y-watal/Distributed-embedded-lab2/design_values_table.html

## Team Defined Values

### Drivetrain

Symbol | Proposed Value | Units | Rationale
THR_MIN | 300 | raw counts (0–32767) | Ignores very small throttle inputs near zero so pedal noise does not command the motors
BRK_MIN | 500 | raw counts (0–32767) | Brake input at or above this value fully applies the brake. Braking is on/off, not proportional
VALID_THR_RANGE | 0–32767 | raw counts | Valid throttle range. Anything outside it triggers a BAD_RANGE fault
VALID_BRK_RANGE | 0–32767 | raw counts | Valid brake range. Anything outside it triggers a BAD_RANGE fault
BRAKE_PRIORITY | Brake overrides throttle | — | If the brake is at or above BRK_MIN, the PID is reset and the H-bridge short-brakes, whatever the throttle is
V_MAX | 650 (≈2.76 rev/s) | mm/s | Target wheel speed at full throttle, set to the speed measured at about 70% duty
Throttle map | v = ((thr − THR_MIN) / (32767 − THR_MIN)) × V_MAX; v = 0 if thr ≤ THR_MIN | — | Monotonic map that starts from zero at the edge of the deadband, so there is no jump in speed
ENC_COUNTS_PER_REV | 1316 | encoder counts / wheel rev | Quadrature counts per wheel revolution. Converts encoder counts to wheel speed
WHEEL_CIRC | 235.6 | mm | Converts wheel revolutions to linear speed
CTRL_PERIOD | 20 | ms | Speed PID sample period
K_P / K_I / K_D | 1.0 / 2.0 / 0.0 | permille duty per mm/s (K_I per mm/s·s) | PI speed controller gains per wheel. Derivative is unused
FF_DUTY | 55% → 70% | duty | Linear feedforward duty from the smallest target speed (55%) up to V_MAX (70%). The PID corrects around it
I_LIMIT | ±40% | duty | Integral clamp with anti-windup
DUTY_MIN | 55% | duty | Lowest duty for a non-zero target (the feedforward floor). If throttle ≤ THR_MIN the motors coast at 0%
DUTY_MAX | 100% | duty | Full throttle sits near 70%, which leaves 30% for the PID to recover under load
PWM_FREQ | 10 | kHz | Frequency of the motor enable PWM
DUTY_STEP | +5% every 20 ms | duty cycle increase | Not implemented in lab 2. Load recovery came from the PI integral
I_OVERLOAD_THRESH | TBD | A | Current threshold above which the motor is considered overloaded
I_OPEN_THRESH | TBD | A | Current threshold below which a commanded motor is considered disconnected

### Steering and force feedback

Symbol | Proposed Value | Units | Rationale
STEER_RANGE | −32767 to +32766 | raw counts | Valid steering input range. Anything outside it triggers a BAD_RANGE fault
STEER_SAT | ±10000 | raw counts | Steering input that gives full servo travel. Inputs beyond it are clamped, not treated as errors
SERVO_MIN/MAX | 500 / 2500 | µs pulse | Servo command range, 0–180° at the servo
SERVO_CENTER | 1500 | µs pulse | Straight ahead. Commanded at startup and whenever the car isn't in NORMAL
SERVO_PERIOD | 20 (50 Hz) | ms | Servo PWM frame period
ANGLE_MAX | ±50 | degrees at the wheels | The servo is commanded ±90°. The wheel angle still has to be measured
Steering Map | pulse = 1500 + steer / 10, after clamping steer to ±STEER_SAT | µs | Linear map from ±10000 to 500–2500 µs
STEER_PERIOD | 20 | ms | Steering task update period. The servo is only written when the angle changes
I_FS | TBD | A | Steering actuator current at maximum force feedback. Set after hardware testing
Force Map | Linear from −I_FS to +I_FS into −100 to +100 | — | Converts measured steering load into the signed force value sent back to the steering wheel
FORCE_DB | 5 | force counts | Ignores very small force values near zero so measurement noise does not create steering wheel feedback

### Blinkers

Symbol | Proposed Value | Units | Rationale
BLINKER_ON | ±5000 | raw steering counts | Steering past this value counts as a deliberate turn and allows the blinker to cancel later
BLINKER_OFF | ±4000 | raw steering counts | The wheel must return inside this value before the active blinker cancels
LEFT_BLINKER_VALID | 0 = Off, 128 = Pressed | raw button value | Any other value triggers a BAD_RANGE fault
RIGHT_BLINKER_VALID | 0 = Off, 128 = Pressed | raw button value | Any other value triggers a BAD_RANGE fault
BLINKER_SELECT | Rising edge toggles | — | Pressing the active side again turns it off. Pressing the other side switches to it
TURN_BLINK_RATE | 1 | Hz | 500 ms on, 500 ms off
HAZARD_BLINK_RATE | 2 | Hz | 250 ms on, 250 ms off. Used in ERROR and SELF_TEST

### Safety

Symbol | Proposed Value | Units | Rationale
CMD_TIMEOUT | 90 | ms | No valid command for this long puts the car in ERROR (brake and hazards). Leaves margin for the 100 ms fault-response requirement
CMD_KEEPALIVE | 50 (minimum spacing 10) | ms | Unchanged state is resent at this rate, and changes are sent at most every 10 ms
FAULT_RECOVERY | Next valid command | — | An out-of-range value invalidates the stored command. Driving resumes only when a new valid command arrives
SAFETY_POLL | 5 | ms | Safety and blinker check rate. Link loss is detected within about 95 ms
BUTTON_DEBOUNCE | 30 | ms | Minimum time between accepted presses of the self-test button
SELF_TEST_EXIT | Double press within 350 | ms | A single press enters self-test (brake and hazards). A double press exits it
