y-watal/Distributed-embedded-lab2/CHANGELOG.md

# Changelog

Lab 5 (Raft consensus and time synchronization) changes on the `lab5` branch,
newest first. Each entry names its commit, what changed, why, and what the
bus showed afterwards. Wire formats and rules are in
[docs/lab5_protocol.md](docs/lab5_protocol.md); the plan is in
[roadmap.md](roadmap.md).

## 2026-11-12

### `4d2fa9f` Heartbeat may wait 0.5 ms for a TX buffer
- **Changed:** a node's own heartbeat waits up to `HB_TX_WAIT_US` (500 µs)
  for an MCP2515 TX buffer instead of `K_NO_WAIT`, only on a bus that is not
  degraded. CTRL, FAULT, BLINK, and relayed frames are unchanged.
  `queue_on()` in `canbus.c` takes the wait as a parameter.
- **Why:** the Zephyr MCP2515 driver frees a buffer slightly after its TX
  callback, so a `K_NO_WAIT` heartbeat could find none free while at most two
  frames were counted in flight. N2's heartbeat on bus B arrived 157/250
  times with a 180 ms gap.
- **Result:** every heartbeat on both buses (10 s capture: N2 500/500 on A and
  B, N3 500/500 and 499/499). N3 shows `full=0`; N2 shows `full` only on bus
  B, from relayed copies.

### `7a5b855` Raft sends are fail-safe; transmit debug counters
- **Changed:** a bulk Raft fragment waits up to 1 ms
  (`RAFT_TX_RESERVE_WAIT_US`) for a spare TX buffer, then is sent anyway with
  the old 2 ms wait, counted as `late`. It is never skipped. N2's relay does
  the same (`raftlate`). Each report bus line adds `tx q=` (frames
  `can_send()` accepted) and `infl N max M late L`.
- **Why:** the first version skipped a fragment after a 3 ms wait. Only
  fragment 0 of every message reached the bus (0 of 109 multi-frame messages
  complete), so N2 sat as a candidate at term 885 while N3 led at term 351.
- **Result:** 100/100 APPEND and APPEND_ACK messages complete; N2 and N3 agree
  on term and leader. `q` matches `ok` and `infl` is 0 when idle, so the
  in-flight count is accurate.

### `ead5b3e` MCP2515 SPI at 8 MHz request (5.25 MHz actual)
- **Changed:** `spi-max-frequency` from 4 MHz to 8 MHz in both STM32 overlays.
  SPI1 on the F401 runs from the 84 MHz APB2 clock with power-of-two dividers,
  so the real clock goes from 2.625 MHz to 5.25 MHz.
- **Why:** N2 relays about 190 frames/s through one SPI bus shared by both
  MCP2515s; its TX completions fell behind and its heartbeats were dropped.
- **Result:** N2's heartbeats on bus A went from 388/500 to 497/500 with no
  CAN errors at the new clock. Bus B still lost about 8% until `4d2fa9f`.

### `39b3912` Keep a TX buffer free for Lab 3 frames
- **STM32:** count frames in flight per bus from `can_send()` to the TX
  callback; bulk Raft fragments may use at most 2 of the 3 MCP2515 buffers
  (`RAFT_TX_MAX_INFLIGHT`). N2's relay applies the rule to relayed fragments
  and keeps forwarding CTRL and FAULT while one waits. N3's `relay.c` now
  matches N2's (it is compiled out on N3).
- **Pi:** Raft frames go out on a separate TX-only socket per bus with
  `SO_PRIORITY` 2 (pfifo_fast band 2); the Lab 3 socket uses 6 (band 0), so
  CTRL and HB are dequeued first. `can_rx` ignores N1's own Raft frames.
  `can_up.sh` raises `txqueuelen` from 10 to 32.
- **Why:** an empty APPEND is 4 fragments back to back; they filled all three
  MCP2515 buffers and the heartbeat, sent with `K_NO_WAIT`, was dropped
  (N3: 1-3 per second).
- **Note:** its skip-on-timeout rule broke Raft; fixed in `7a5b855`.

### `88ab415` Stop the CLIENT_REPLY storm; heartbeats outrank bulk Raft
- **CAN IDs:** REF stays at `0x040`-`0x042`. Votes, appends, and client
  messages move from `0x044`-`0x05A` to `0x140`-`0x156`, above the heartbeats
  (`0x100`-`0x102`). STM32 receive filters stay at six: BLINK and FORCE share
  one. `raft_id_slot()` keeps the transport's reassembly table compact.
- **Client pacing** (`shared/raft_agent.c`): link, node, and cockpit reports go
  through `raft_client_observe()` and are logged only after holding 50 ms
  (loss) or 100 ms (recovery). A newer state replaces a queued one for the
  same link or node. After `REJECTED` the client waits 1 s instead of 100 ms.
  The leader stays silent while another entry is in flight and answers its own
  client locally instead of over CAN.
- **Why:** the 64-entry log filled, the leader rejected every update, and
  clients resent every 100 ms (about 90 rejected replies/s per bus). That
  traffic outranked heartbeats, gaps reached 60-80 ms, DEG flickered, and each
  flicker added two more log reports. The term had reached 1389.
- **Tests:** host tests cover the ID order and filter masks, debounce,
  coalescing, the 1 s backoff, and the leader rejecting its own request
  without sending a frame.

### `2c9625f` Initial Raft
- Shared portable Raft core in `shared/` used by the Pi and both STM32s:
  `protocol.h` (CAN IDs), `raft_wire.h` (message codecs), `raft_transport.c`
  (5-byte fragments and reassembly), and `raft_agent.c` (roles, terms,
  elections, one-entry APPEND, commit on majority, network graph).
- Default startup: N1 leader in term 1, REF every 20 ms, empty APPEND every
  100 ms; followers elect after 3 missed REFs plus 0-39 ms of random delay.
  `RAFT_DEFAULT_LEADER -1` starts with an election instead.
- Lab 3 heartbeat monitors report CANLINK and NODE changes; the Pi reports
  COCKPIT_OK and COCKPIT_ERROR. Each node prints its term, log, and graph once
  a second.
- Host tests: `tests/raft_wire_test.c`, `raft_transport_test.c`,
  `raft_agent_test.c`.

## Known issues
- **Log capacity:** the working log holds 64 entries in RAM and is lost on
  reset. When full, the leader rejects every update. Needs a ring buffer with
  snapshots.
- **N2 relays everything:** about 70 relayed Raft frames/s are duplicates when
  all links are up, and relayed copies on bus B still fail with `full`.
  Relaying Raft frames only when the sender is not heard on the other bus
  would remove that load.
- **Elections:** no Pre-Vote or CheckQuorum, and a restarted cockpit claims
  term-1 leadership with an empty log, so the term can climb (checkoff step 10).
- **Not started:** clock synchronization (`global_gettime()`, drift), PPS,
  blinkers on global time, LEADER and SYNC indicators, failure-mode hazards,
  graph-based routing.
