y-watal/Distributed-embedded-lab2/schematic/KiCAD.kicad_sch

## KiCad design schematic/KiCAD.kicad_sch (2026-10-01, an earlier design)

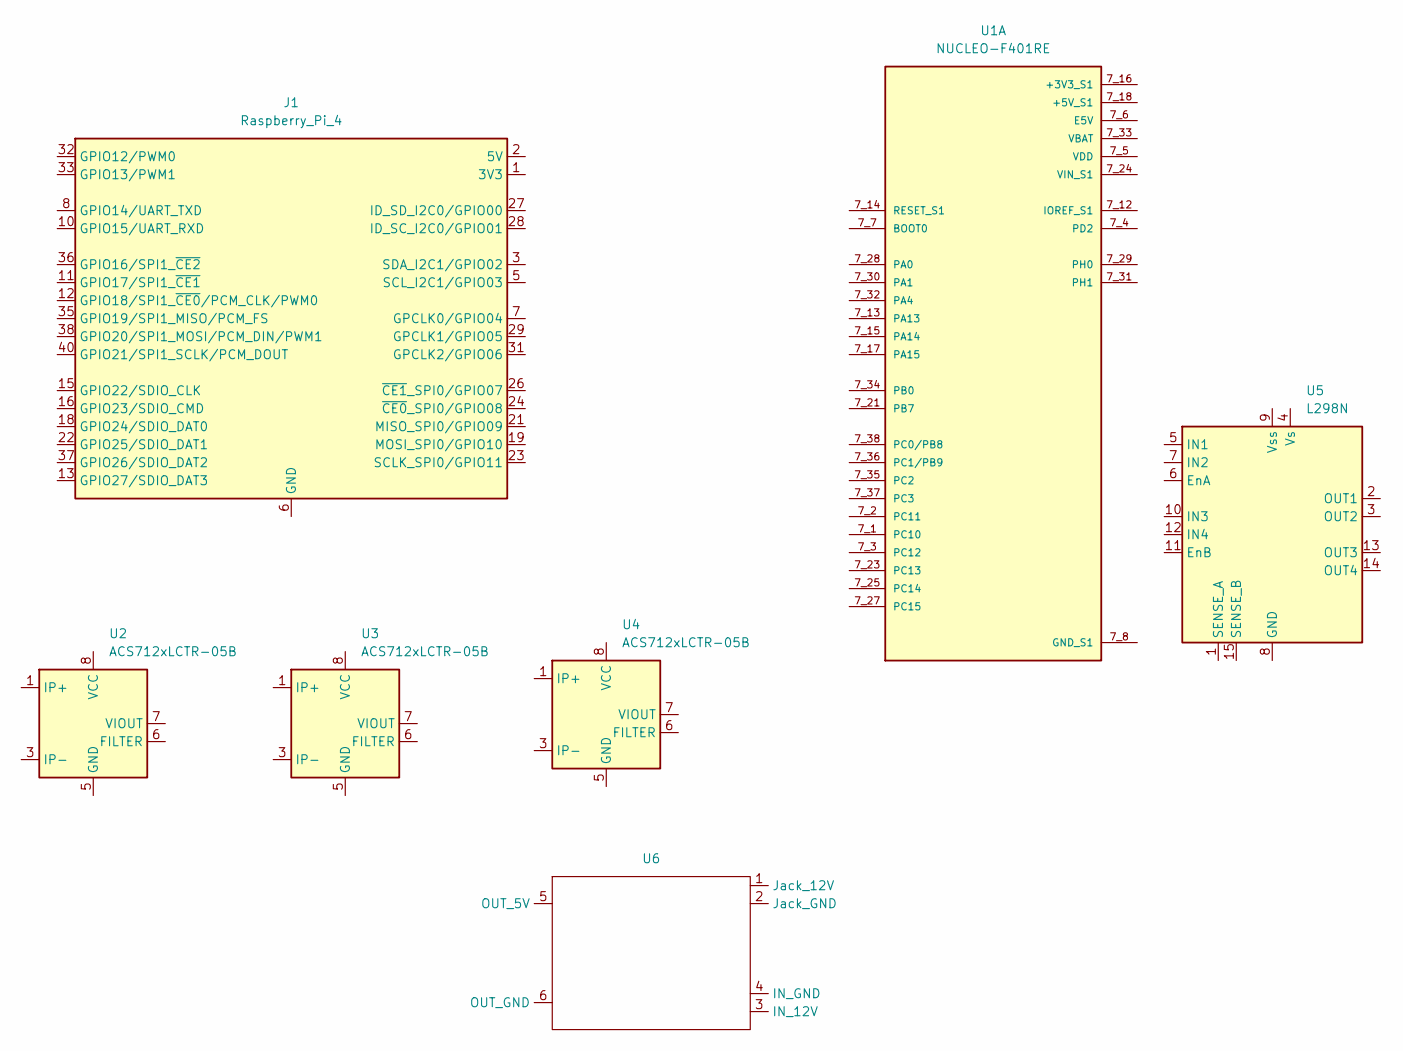
[picture p1: schematic KiCAD.kicad_sch]

Parts:
J1: Raspberry_Pi_4
U1: NUCLEO-F401RE; ST_NUCLEO-F401RE; PARTREV 13
U2, U3, U4: ACS712xLCTR-05B; SOIC-8_3.9x4.9mm_P1.27mm
U5: L298N; TO-220-15_P2.54x5.08mm_StaggerOdd_Lead4.58mm_Vertical
U6: WDFN-10-1EP_3x3mm_P0.5mm_EP1.8x2.5mm

Connections:
unnamed: J1.1 (3V3), J1.17 (3V3)
unnamed: J1.2 (5V), J1.4 (5V)
unnamed: J1.6 (GND), J1.9 (GND), J1.14 (GND), J1.20 (GND), J1.25 (GND), J1.30 (GND), J1.34 (GND), J1.39 (GND)
unnamed: U1.7_8 (GND_S1), U1.7_19 (GND_S1), U1.7_20 (GND_S1), U1.7_22 (GND_S1)
unnamed: U2.1 (IP+), U2.2 (IP+)
unnamed: U2.3 (IP-), U2.4 (IP-)
unnamed: U3.1 (IP+), U3.2 (IP+)
unnamed: U3.3 (IP-), U3.4 (IP-)
unnamed: U4.1 (IP+), U4.2 (IP+)
unnamed: U4.3 (IP-), U4.4 (IP-)
