y-watal/Distributed-embedded-lab2/schematic/Lab3.kicad_sch

## KiCad design schematic/Lab3.kicad_sch (2026-10-21)

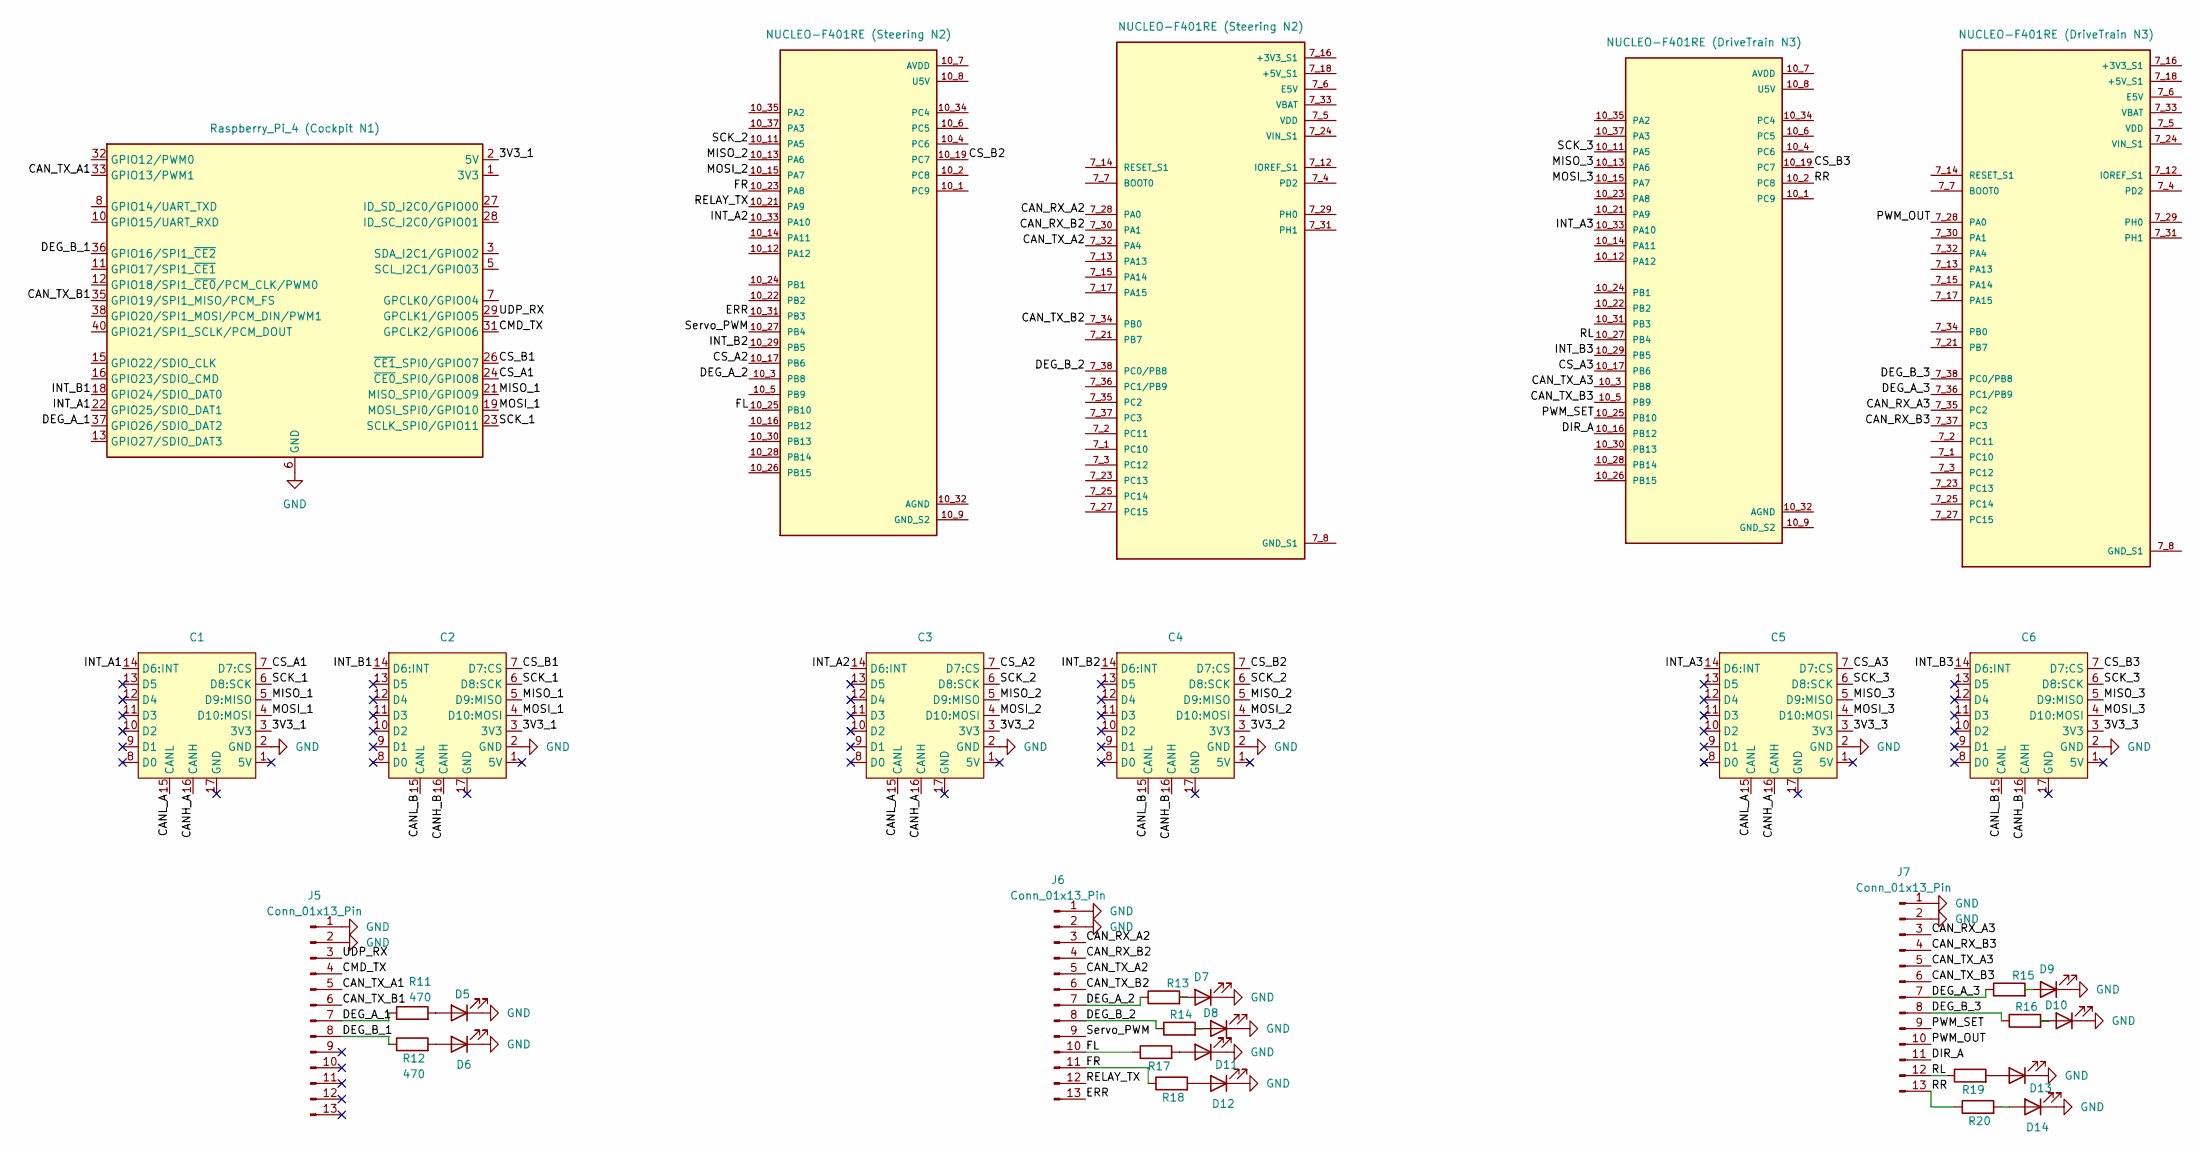
[picture p2: schematic Lab3.kicad_sch]

Parts:
C1, C2, C3, C4, C5, C6: (no value)
D5, D6, D7, D8, D9, D10, D11, D12, D13, D14: LED
J4: Raspberry_Pi_4 (Cockpit N1)
J5, J6, J7: Conn_01x13_Pin
R11, R13, R15, R17, R19: 470; DIP-8_W7.62mm
R12, R14, R16, R18, R20: 470
U6: NUCLEO-F401RE (DriveTrain N3); ST_NUCLEO-F401RE; PARTREV 13
U7: NUCLEO-F401RE (Steering N2); ST_NUCLEO-F401RE; PARTREV 13

Connections:
3V3_1: C1.3 (3V3), C2.3 (3V3), J4.2 (5V), J4.4 (5V)
3V3_2: C3.3 (3V3), C4.3 (3V3)
3V3_3: C5.3 (3V3), C6.3 (3V3)
CANH_A: C1.16 (CANH), C3.16 (CANH), C5.16 (CANH)
CANH_B: C2.16 (CANH), C4.16 (CANH), C6.16 (CANH)
CANL_A: C1.15 (CANL), C3.15 (CANL), C5.15 (CANL)
CANL_B: C2.15 (CANL), C4.15 (CANL), C6.15 (CANL)
CAN_RX_A2: J6.3, U7.7_28 (PA0)
CAN_RX_A3: J7.3, U6.7_35 (PC2)
CAN_RX_B2: J6.4, U7.7_30 (PA1)
CAN_RX_B3: J7.4, U6.7_37 (PC3)
CAN_TX_A1: J4.33 (GPIO13/PWM1), J5.5
CAN_TX_A2: J6.5, U7.7_32 (PA4)
CAN_TX_A3: J7.5, U6.10_3 (PB8)
CAN_TX_B1: J4.35 (GPIO19/SPI1_MISO/PCM_FS), J5.6
CAN_TX_B2: J6.6, U7.7_34 (PB0)
CAN_TX_B3: J7.6, U6.10_5 (PB9)
CMD_TX: J4.31 (GPCLK2/GPIO06), J5.4
CS_A1: C1.7 (D7:CS), J4.24 (~CE0_SPI0/GPIO08)
CS_A2: C3.7 (D7:CS), U7.10_17 (PB6)
CS_A3: C5.7 (D7:CS), U6.10_17 (PB6)
CS_B1: C2.7 (D7:CS), J4.26 (~CE1_SPI0/GPIO07)
CS_B2: C4.7 (D7:CS), U7.10_19 (PC7)
CS_B3: C6.7 (D7:CS), U6.10_19 (PC7)
DEG_A_1: J4.37 (GPIO26/SDIO_DAT2), J5.7, R11.1
DEG_A_2: J6.7, R13.1, U7.10_3 (PB8)
DEG_A_3: J7.7, R15.1, U6.7_36 (PC1/PB9)
DEG_B_1: J4.36 (GPIO16/SPI1_~CE2), J5.8, R12.1
DEG_B_2: J6.8, R14.1, U7.7_38 (PC0/PB8)
DEG_B_3: J7.8, R16.1, U6.7_38 (PC0/PB8)
DIR_A: J7.11, U6.10_16 (PB12)
ERR: J6.13, U7.10_31 (PB3)
FL: J6.10, R17.1, U7.10_25 (PB10)
FR: J6.11, R18.1, U7.10_23 (PA8)
GND: C1.2 (GND), C2.2 (GND), C3.2 (GND), C4.2 (GND), C5.2 (GND), C6.2 (GND), D5.1 (K), D6.1 (K), D7.1 (K), D8.1 (K), D9.1 (K), D10.1 (K), D11.1 (K), D12.1 (K), D13.1 (K), D14.1 (K), J4.6 (GND), J4.9 (GND), J4.14 (GND), J4.20 (GND), J4.25 (GND), J4.30 (GND), J4.34 (GND), J4.39 (GND), J5.1, J5.2, J6.1, J6.2, J7.1, J7.2
INT_A1: C1.14 (D6:INT), J4.22 (GPIO25/SDIO_DAT1)
INT_A2: C3.14 (D6:INT), U7.10_33 (PA10)
INT_A3: C5.14 (D6:INT), U6.10_33 (PA10)
INT_B1: C2.14 (D6:INT), J4.18 (GPIO24/SDIO_DAT0)
INT_B2: C4.14 (D6:INT), U7.10_29 (PB5)
INT_B3: C6.14 (D6:INT), U6.10_29 (PB5)
MISO_1: C1.5 (D9:MISO), C2.5 (D9:MISO), J4.21 (MISO_SPI0/GPIO09)
MISO_2: C3.5 (D9:MISO), C4.5 (D9:MISO), U7.10_13 (PA6)
MISO_3: C5.5 (D9:MISO), C6.5 (D9:MISO), U6.10_13 (PA6)
MOSI_1: C1.4 (D10:MOSI), C2.4 (D10:MOSI), J4.19 (MOSI_SPI0/GPIO10)
MOSI_2: C3.4 (D10:MOSI), C4.4 (D10:MOSI), U7.10_15 (PA7)
MOSI_3: C5.4 (D10:MOSI), C6.4 (D10:MOSI), U6.10_15 (PA7)
unnamed: D5.2 (A), R11.2
unnamed: D6.2 (A), R12.2
unnamed: D7.2 (A), R13.2
unnamed: D8.2 (A), R14.2
unnamed: D9.2 (A), R15.2
unnamed: D10.2 (A), R16.2
unnamed: D11.2 (A), R17.2
unnamed: D12.2 (A), R18.2
unnamed: D13.2 (A), R19.2
unnamed: D14.2 (A), R20.2
unnamed: J4.1 (3V3), J4.17 (3V3)
unnamed: U6.7_8 (GND_S1), U6.7_19 (GND_S1), U6.7_20 (GND_S1), U6.7_22 (GND_S1)
unnamed: U6.10_9 (GND_S2), U6.10_20 (GND_S2)
unnamed: U7.7_8 (GND_S1), U7.7_19 (GND_S1), U7.7_20 (GND_S1), U7.7_22 (GND_S1)
unnamed: U7.10_9 (GND_S2), U7.10_20 (GND_S2)
PWM_OUT: J7.10, U6.7_28 (PA0)
PWM_SET: J7.9, U6.10_25 (PB10)
RELAY_TX: J6.12, U7.10_21 (PA9)
RL: J7.12, R19.1, U6.10_27 (PB4)
RR: J7.13, R20.1, U6.10_2 (PC8)
SCK_1: C1.6 (D8:SCK), C2.6 (D8:SCK), J4.23 (SCLK_SPI0/GPIO11)
SCK_2: C3.6 (D8:SCK), C4.6 (D8:SCK), U7.10_11 (PA5)
SCK_3: C5.6 (D8:SCK), C6.6 (D8:SCK), U6.10_11 (PA5)
Servo_PWM: J6.9, U7.10_27 (PB4)
UDP_RX: J4.29 (GPCLK1/GPIO05), J5.3
