y-watal/Distributed-embedded-lab2/node2_front/src/lab3_config.h

/*
 * Every timing threshold and thread priority in one place (handout Part 5).
 * Derivations: docs/lab3_design.md.
 */
#ifndef LAB3_CONFIG_H
#define LAB3_CONFIG_H

/* Heartbeats (R4.5): every 20 ms +-10 %. */
#define HB_PERIOD_MS       20
#define HB_MAX_INTERVAL_MS 22

/*
 * A bus is degraded at this node when no other node's heartbeat has arrived on
 * it for DEG_TIMEOUT_MS. Worst-case detection is DEG_TIMEOUT_MS + MONITOR_PERIOD_MS
 * = 49 ms, inside R4.7's 60 ms. Two intervals keeps it clear of the longest
 * healthy gap (~24 ms), so the LED doesn't flicker.
 */
#define DEG_TIMEOUT_MS (2 * HB_MAX_INTERVAL_MS)

/*
 * A zone has failed when its heartbeat has been missing on both buses for
 * FAIL_TIMEOUT_MS: three missed heartbeats, each allowed its 22 ms window.
 * Worst case 66 + 5 = 71 ms, leaving 29 ms of the 100 ms system-error budget.
 */
#define FAIL_TIMEOUT_MS (3 * HB_MAX_INTERVAL_MS)

#define MONITOR_PERIOD_MS 5

/*
 * Copies of one (ID, seq) - bus A, bus B, relayed - all arrive within a few ms.
 * A repeat of the same seq inside this window is a duplicate; outside it, the
 * 4-bit counter has wrapped and it's a new frame. Must stay below the shortest
 * interval between two frames of one ID (18 ms).
 */
#define DUP_WINDOW_MS 10

#define REPORT_PERIOD_MS 1000

/*
 * CTRL older than this is stale: actuators go to their safe state (brake /
 * center). Lab 2's 90 ms: four missed 20 ms CTRL frames, plus margin.
 */
#define CTRL_TIMEOUT_MS 90

/* Actuator tasks re-check CTRL freshness and zone state at least this often. */
#define ACTUATOR_POLL_MS 5

#define PID_PERIOD_MS     10 /* N3 speed loop (template: PID every 10 ms) */
#define CURRENT_PERIOD_MS 20 /* current sensor sampling */

/* Zone state machine (docs/lab3_design.md, "Zone state and fault protocol") */
#define TEST_BTN_DEBOUNCE_MS 50   /* template: TEST_BTN min interarrival 50 ms */
#define DOUBLE_PRESS_MS      350  /* second press within this clears the test fault */
#define CTRL_FAULT_HOLD_MS   1000 /* a rejected CTRL keeps the zone in error this long */
#define FAULT_CLEAR_HOLD_MS  (HB_MAX_INTERVAL_MS + 3) /* older HB may overtake a FAULT */
#define FAULT_MIN_GAP_MS     20   /* catalog: FAULT min interval */

/* Blinkers */
#define BLINK_HALF_MS  500  /* local hazard rate when the cockpit can't be heard (1 Hz) */
/*
 * No BLINK for this long while N1's heartbeat is still heard: flash hazards
 * locally. Losing the cockpit is detected by the heartbeat (66 ms); this is
 * only a backstop for a cockpit that is alive but has stopped sending BLINK,
 * so it tolerates 5 lost toggles. At 1100 ms (2 lost), a couple of frames
 * dropped on a single-path relay (one bus unplugged) put up false hazards.
 */
#define BLINK_STALE_MS (5 * BLINK_HALF_MS + 100)

/* FORCE_TX (N2): dummy counter every 50 ms */
#define FORCE_PERIOD_MS 50

/* Independent watchdog (R4.5): fed only while HB_TX and the actuator task check in. */
#define WDT_TIMEOUT_MS 250
#define WDT_CHECK_MS   100

/* Boot-time test point walk, ms per point; 0 skips it. */
#define TP_WALK_MS 300

/*
 * Thread priorities (lower number = higher priority). The MCP2515 driver's two
 * interrupt threads run at CONFIG_CAN_MCP2515_INT_THREAD_PRIO (2), above all of these.
 * RELAY sits above DISPATCH so a forwarded CTRL goes out before N2's own tasks
 * see the frame: it is on N3's brake path.
 */
/*
 * Lab 5: bulk Raft fragments prefer to occupy at most 2 of the MCP2515's 3
 * TX buffers, so a K_NO_WAIT heartbeat, CTRL, or FAULT finds one free. A
 * fragment waits up to RAFT_TX_RESERVE_WAIT_US for that, then is sent anyway
 * (with the old 2 ms wait for any buffer) and counted as "late". Skipping
 * fragments instead lost every multi-frame message (N2/N3 split, term 885).
 */
/*
 * Own heartbeat waits up to this long for an MCP2515 TX buffer instead of
 * K_NO_WAIT (the driver frees a buffer slightly after the TX callback).
 * Adds at most this much heartbeat jitter, far inside HB_MAX_INTERVAL_MS.
 */
#define HB_TX_WAIT_US           500

#define RAFT_TX_MAX_INFLIGHT    2
#define RAFT_TX_RESERVE_WAIT_US 1000

#define PRIO_RELAY    3
#define PRIO_DISPATCH 4
#define PRIO_DRIVE    5 /* N3: acts on CTRL (brake path, local deadline 0.5 ms) */
#define PRIO_STEER    5 /* N2: acts on CTRL (local deadline 1 ms) */
#define PRIO_BLINK    5 /* BLINK_F / BLINK_R: 0.5 ms from reception */
#define PRIO_TEST_BTN 5 /* local fail within 10 ms (R2.5) */
#define PRIO_PID      6 /* N3: speed loop every 10 ms */
#define PRIO_HB_TX    7
#define PRIO_HB_MON   8 /* also runs the zone state machine and feeds the watchdog */
#define PRIO_FORCE    9 /* N2: FORCE every 50 ms */
#define PRIO_CURRENT  10
#define PRIO_REPORT   12
#define PRIO_EVLOG    13 /* event lines; below REPORT so it never splits a summary */

/*
 * WCET measurement (src/wcet.c): CPU time per job from Zephyr's per-thread
 * usage counter, which stops while the thread is preempted or blocked.
 * Needs CONFIG_THREAD_RUNTIME_STATS / CONFIG_SCHED_THREAD_USAGE in prj.conf.
 * 0 compiles every probe away.
 */
#define WCET_MEASURE      1
#define WCET_REPORT_EVERY 5 /* print the WCET table with every 5th summary */

/*
 * Queuing jitter J per message (src/jitter.c): trigger -> frame queued in the
 * MCP2515, wall clock, per bus. 0 compiles the recording away.
 */
#define JITTER_MEASURE      1
#define JITTER_REPORT_EVERY 5 /* print with every 5th summary; "last" = that window */

#endif /* LAB3_CONFIG_H */
