y-watal/Distributed-embedded-lab2/pi/state.h

typedef struct DIJOYSTATE2 {
    int lX;
    int lY;
    int lZ;
    int lRx;
    int lRy;
    int lRz;
    int rglSlider[2];
    unsigned rgdwPOV[4];
    char rgbButtons[128];
    int lVX;
    int lVY;
    int lVZ;
    int lVRx;
    int lVRy;
    int lVRz;
    int rglVSlider[2];
    int lAX;
    int lAY;
    int lAZ;
    int lARx;
    int lARy;
    int lARz;
    int rglASlider[2];
    int lFX;
    int lFY;
    int lFZ;
    int lFRx;
    int lFRy;
    int lFRz;
    int rglFSlider[2];
} DIJOYSTATE2_t;
