y-watal/Distributed-embedded-lab2/node2_front/src/canbus.h

/*
 * Shared dual-CAN layer.
 *
 *  - Both MCP2515 controllers, with receive filters for the catalog IDs only.
 *  - canbus_send(): queues one frame on bus A and bus B back to back with the
 *    same per-ID sequence number, bumped once.
 *  - One dispatch thread that drops duplicates by (ID, seq) - the A copy, the
 *    B copy and any relayed copy - before anything else sees the frame, and
 *    records when each node's heartbeat was last heard on each bus.
 */
#ifndef CANBUS_H
#define CANBUS_H

#include <stdbool.h>
#include <stdint.h>
#include <zephyr/drivers/can.h>
#include <zephyr/sys/atomic.h>

#include "catalog.h"

enum { BUS_A = 0, BUS_B = 1, NUM_BUSES = 2 };

/* Called from the dispatch thread with the first copy of each frame. */
typedef void (*canbus_handler_t)(const struct can_frame *frame, int bus);

int canbus_init(void);

/* Receivers of first copies. The relay hook runs before the application handler. */
void canbus_set_relay_hook(canbus_handler_t hook);
void canbus_set_handler(canbus_handler_t handler);

/*
 * Sends payload (bytes 1-7 used; byte 0 is overwritten with the sequence
 * number) on both buses. Buses marked degraded are skipped unless
 * include_degraded is set (heartbeats keep going out so the link can recover).
 */
int canbus_send(uint32_t id, uint8_t payload[FRAME_DLC], bool include_degraded);

/*
 * Same, recording J = now - release (k_cycle_get_32() of the triggering event,
 * from jit_now()) per bus once each copy is queued. release 0 records nothing.
 */
int canbus_send_at(uint32_t id, uint8_t payload[FRAME_DLC], bool include_degraded,
		   uint32_t release);

/* Sends one raw Lab 5 frame without overwriting byte 0 with a Lab 3 sequence. */
/*
 * True while bulk Raft frames may use another TX buffer on this bus: at most
 * RAFT_TX_MAX_INFLIGHT of the MCP2515's three, so Lab 3 frames keep one.
 */
bool canbus_raft_tx_ready(int bus);

/*
 * Wait up to RAFT_TX_RESERVE_WAIT_US for canbus_raft_tx_ready(). Returns
 * false on timeout; the caller then sends anyway (fail-safe: a Raft message
 * is never abandoned part-way because of the reserve).
 */
bool canbus_raft_wait_reserve(int bus);

/* Frames handed to the MCP2515 and not yet completed (debug). */
long canbus_tx_inflight(int bus);
int canbus_send_raft(uint32_t id, const uint8_t payload[FRAME_DLC]);

/* Queues a bit-identical copy of frame on one bus (the relay). */
int canbus_forward(int bus, const struct can_frame *frame);
int canbus_forward_at(int bus, const struct can_frame *frame, uint32_t release);

/* In a relay hook / handler: k_cycle_get_32() when rx_cb got this frame. */
uint32_t canbus_rx_cycles(void);

/* Aborts every transmission still pending on bus (stale frames on a dead link). */
void canbus_flush(int bus);

bool canbus_bus_running(int bus);
void canbus_set_degraded(int bus, bool degraded);
bool canbus_is_degraded(int bus);

/*
 * k_uptime_get_32() of the last heartbeat from node on bus (any copy, relayed
 * or not); 0 = never heard.
 */
uint32_t canbus_last_hb_ms(int bus, int node);

/* True once if the controller went bus-off since the last call. */
bool canbus_take_busoff(int bus);

/* ---- statistics, read and cleared by the report thread ---- */
#define CANBUS_NUM_SLOTS 9 /* catalog IDs */

struct canbus_bus_stats {
	atomic_t rx[CANBUS_NUM_SLOTS]; /* every copy received on this bus */
	atomic_t tx_ok, tx_err, tx_full, tx_skipped;
	atomic_t tx_queued; /* can_send() accepted; should equal tx_ok + tx_err */
	atomic_t raft_late; /* Raft sent without the reserve: none free within the wait */
	atomic_t infl_max;  /* most frames in flight seen at a send */
};

struct canbus_stats {
	struct canbus_bus_stats bus[NUM_BUSES];
	atomic_t accepted[CANBUS_NUM_SLOTS]; /* first copies */
	atomic_t gaps[CANBUS_NUM_SLOTS];     /* sequence numbers never received */
	atomic_t duplicates, own_echo, unknown_id, rx_dropped;
};

extern struct canbus_stats canbus_stats;
extern const uint16_t canbus_slot_id[CANBUS_NUM_SLOTS];
const struct device *canbus_dev(int bus);

#endif /* CANBUS_H */
