y-watal/Distributed-embedded-lab2/node3_rear/src/report.c

#include "report.h"

#include <zephyr/kernel.h>
#include <zephyr/sys/printk.h>

#include "app.h"
#include "blink.h"
#include "zone.h"
#include "canbus.h"
#include "ctrl.h"
#include "hb.h"
#include "lab3_config.h"
#include "node_config.h"
#include "relay.h"
#include "raft_node.h"
#include "jitter.h"
#include "wcet.h"

#define REPORT_STACK_SIZE 1536

K_THREAD_STACK_DEFINE(report_stack, REPORT_STACK_SIZE);
static struct k_thread report_data;

static const char *can_state_name(enum can_state state)
{
	switch (state) {
	case CAN_STATE_ERROR_ACTIVE:
		return "error-active";
	case CAN_STATE_ERROR_WARNING:
		return "error-warning";
	case CAN_STATE_ERROR_PASSIVE:
		return "error-passive";
	case CAN_STATE_BUS_OFF:
		return "bus-off";
	case CAN_STATE_STOPPED:
		return "stopped";
	default:
		return "?";
	}
}

static void print_counts(atomic_t *counts, atomic_t *gaps)
{
	bool any = false;

	for (int i = 0; i < CANBUS_NUM_SLOTS; i++) {
		long n = (long)atomic_clear(&counts[i]);
		long g = gaps ? (long)atomic_clear(&gaps[i]) : 0;

		if (n == 0 && g == 0) {
			continue;
		}
		printk(" 0x%03x x%ld", canbus_slot_id[i], n);
		if (g) {
			printk(" (gaps %ld)", g);
		}
		any = true;
	}
	if (!any) {
		printk(" (nothing)");
	}
}

static void report_thread(void *p1, void *p2, void *p3)
{
	int64_t next = k_uptime_get() + REPORT_PERIOD_MS;
	struct wcet_job job = WCET_JOB(WCET_REPORT);
	unsigned int reports = 0;

	ARG_UNUSED(p1);
	ARG_UNUSED(p2);
	ARG_UNUSED(p3);

	for (;;) {
		wcet_end(&job);
		k_sleep(K_TIMEOUT_ABS_MS(next));
		wcet_begin(&job);
		next += REPORT_PERIOD_MS;

		uint32_t ms = k_uptime_get_32();
		struct canbus_stats *s = &canbus_stats;

		uint8_t lf = zone_local_fault();

		printk("[%s %u.%03us] %s", NODE_NAME, ms / 1000, ms % 1000,
		       zone_state_name(zone_state()));
		if (lf) {
			printk(" (local fault 0x%02x)", lf);
		}
		printk(" | peers:");
		for (int n = 0; n < NUM_NODES; n++) {
			uint8_t code;

			if (n == NODE_SELF) {
				continue;
			}
			if (!hb_peer_alive(n)) {
				printk(" N%d LOST", n + 1);
			} else if (zone_peer_fault(n, &code)) {
				printk(" N%d fault 0x%02x", n + 1, code);
			} else {
				printk(" N%d %s", n + 1, zone_state_name(zone_peer_state(n)));
			}
		}
		printk(" | dup %ld echo %ld rxdrop %ld", (long)atomic_clear(&s->duplicates),
		       (long)atomic_clear(&s->own_echo), (long)atomic_clear(&s->rx_dropped));
		if (RELAY_ENABLED) {
			printk(" | relay %ld skip %ld drop %ld raftlate %ld",
			       (long)atomic_clear(&relay_stats.forwarded),
			       (long)atomic_clear(&relay_stats.skipped),
			       (long)atomic_clear(&relay_stats.dropped),
			       (long)atomic_clear(&relay_stats.raft_late));
		}
		printk("\n");

		for (int bus = 0; bus < NUM_BUSES; bus++) {
			struct canbus_bus_stats *b = &s->bus[bus];

			if (!canbus_bus_running(bus)) {
				printk("  %c: not running\n", 'A' + bus);
				continue;
			}
			enum can_state st;
			struct can_bus_err_cnt err = {0};

			can_get_state(canbus_dev(bus), &st, &err);
			/* MCP2515 RX overruns: a frame arrived with both RX buffers still unread. */
			static uint32_t ovr_prev[NUM_BUSES];
			uint32_t ovr = 0;
#ifdef CONFIG_CAN_STATS
			uint32_t ovr_now = can_stats_get_rx_overruns(canbus_dev(bus));

			ovr = ovr_now - ovr_prev[bus];
			ovr_prev[bus] = ovr_now;
#endif
			printk("  %c: %s tec=%u rec=%u ovr=%u DEG %d | tx q=%ld ok=%ld err=%ld full=%ld skip=%ld"
			       " | infl %ld max %ld late %ld | rx:",
			       'A' + bus, can_state_name(st), err.tx_err_cnt, err.rx_err_cnt, ovr,
			       hb_bus_degraded(bus), (long)atomic_clear(&b->tx_queued),
			       (long)atomic_clear(&b->tx_ok),
			       (long)atomic_clear(&b->tx_err), (long)atomic_clear(&b->tx_full),
			       (long)atomic_clear(&b->tx_skipped), canbus_tx_inflight(bus),
			       (long)atomic_clear(&b->infl_max), (long)atomic_clear(&b->raft_late));
			print_counts(b->rx, NULL);
			printk("\n");
		}
		printk("  accepted:");
		print_counts(s->accepted, s->gaps);
		printk("\n");
		raft_node_print_status();

		struct ctrl_cmd cmd;
		uint32_t age;

		printk("  ctrl: ok %ld malformed %ld range %ld", (long)atomic_clear(&ctrl_stats.ok),
		       (long)atomic_clear(&ctrl_stats.malformed),
		       (long)atomic_clear(&ctrl_stats.out_of_range));
		if (ctrl_get(&cmd, &age)) {
			printk(" | last: steer %d throttle %u brake %u buttons 0x%x, %u ms ago",
			       cmd.steer, cmd.throttle, cmd.brake, cmd.buttons, age);
		}
		printk("\n");
		printk("  blink: %s\n", blink_describe());
		app_report();
		++reports;
		if (WCET_MEASURE && reports % WCET_REPORT_EVERY == 0) {
			wcet_report();
		}
		if (JITTER_MEASURE && reports % JITTER_REPORT_EVERY == 0) {
			jit_report();
		}
	}
}

int report_init(void)
{
	k_thread_create(&report_data, report_stack, K_THREAD_STACK_SIZEOF(report_stack),
			report_thread, NULL, NULL, NULL, PRIO_REPORT, 0, K_NO_WAIT);
	k_thread_name_set(&report_data, "report");
	return 0;
}
