y-watal/Distributed-embedded-lab2/(commit log)

2026-09-24 flashed basic LED blink
2026-09-24 button and led blink :D
2026-09-29 Pi UDP Proxy (status frame not yet implemented)
2026-09-29 sending pi frame
2026-10-01 added schematic
    [KiCAD.kicad_pcb, KiCAD.kicad_sch]
2026-10-01 new schematic
    [KiCAD.kicad_sch]
2026-10-01 Updated schematic connections
    [KiCAD.kicad_sch]
2026-10-21 Steering & Rear; TODO: Cockpit zone
2026-10-21 Add Lab 3 schematic and CAN breakout symbol
2026-10-21 Disabled PID loop
2026-11-12 Sped up SPI to 8MHz
